redknightlois/dyi-drone/3d-parts/components/lm2596.md

# LM2596 DC-DC Buck Converter Module — Reference Specs

Adjustable step-down converter with built-in 3-digit LED voltmeter display,
two control buttons (ON/OFF and IN/OUT mode), voltage-adjustment potentiometer,
and IN/OUT indicator LEDs.

## PCB Dimensions

| Parameter | Value |
|---|---|
| PCB Length | 66 mm |
| PCB Width | 35 mm |
| PCB Thickness | 1.6 mm |
| Total Height (with components) | 14 mm |
| Weight | ~22 g |

## Mounting Holes

| Parameter | Value |
|---|---|
| Hole Pattern (L × W) | 60 × 28 mm |
| Hole Diameter | 3.0 mm (M3) |
| Hole Inset from PCB Edge (X) | 3.0 mm |
| Hole Inset from PCB Edge (Y) | 3.5 mm |

## Component Heights (above PCB)

| Component | Height | Footprint |
|---|---|---|
| LM2596 IC + Heatsink | 10 mm | 15 × 12 mm rect |
| LED 7-Segment Display | 8 mm | 30 × 14 mm rect |
| Screw Terminals (×2) | 8 mm | 10 × 7 mm rect each |
| Potentiometer (trimpot) | 5 mm | ∅6 mm |
| Control Buttons (×2) | 3 mm | ~3.5 × 3.5 mm each |
| IN/OUT Indicator LEDs (×2) | ~1 mm | SMD (~2 × 1 mm each) |
| Inductor | 6 mm | ∅10 mm |
| Electrolytic Capacitors (×2) | 8 mm | ∅8 mm each |

## Component Details

### Screw Terminals (2×)

| Parameter | Value |
|---|---|
| Terminal Block Size (L × W × H) | 10 × 7 × 8 mm |
| Wire Access Direction | ±X end walls (horizontal) |

### LM2596 IC + Heatsink

| Parameter | Value |
|---|---|
| Footprint | 15 × 12 mm |
| Height above PCB | 10 mm (tallest component) |
| Notes | Generates heat; benefits from ventilation |

### LED 7-Segment Display (3-digit voltmeter)

| Parameter | Value |
|---|---|
| Display Module Size (L × W) | 30 × 14 mm |
| Active Digit Area | ~22 × 13 mm |
| Height above PCB | 8 mm |
| Digit Color | Red |
| Voltmeter Range | 0 – 40 V |
| Voltmeter Precision | ±0.1 V (calibratable to ±0.05 V) |

### Potentiometer (Voltage Adjustment Trimpot)

| Parameter | Value |
|---|---|
| Type | Multi-turn cermet trimpot (blue) |
| Diameter | 6 mm |
| Height above PCB | 5 mm |
| Adjustment Tool | Slot-head screwdriver |
| CW Rotation | Increases output voltage |
| CCW Rotation | Decreases output voltage |

### Control Buttons (2×, tactile switches)

| Parameter | Left Button | Right Button |
|---|---|---|
| Label | ON/OFF | IN/OUT |
| Size | ~3.5 × 3.5 mm | ~3.5 × 3.5 mm |
| Height above PCB | ~3 mm | ~3 mm |

**Left Button (ON/OFF) Functions:**
- Short press: toggle voltmeter display on/off
- Long press >1 s: shut down voltmeter display
- Long press >4 s: enter self-calibration mode (range ±0.5 V)

**Right Button (IN/OUT) Functions:**
- Short press: switch display between input voltage (IN LED on) and output voltage (OUT LED on)
- Long press >2 s (calibration mode): switch between IN/OUT calibration, save value

### IN/OUT Indicator LEDs (2×)

| Parameter | Value |
|---|---|
| Type | SMD, red |
| Size | ~2 × 1 mm each |
| IN LED | Lit when displaying input voltage |
| OUT LED | Lit when displaying output voltage |

### Inductor

| Parameter | Value |
|---|---|
| Diameter | ~10 mm |
| Height above PCB | 6 mm |

### Electrolytic Capacitors (2×)

| Parameter | Input Cap | Output Cap |
|---|---|---|
| Diameter | ~8 mm | ~8 mm |
| Height above PCB | 8 mm | 8 mm |

### Internal ICs (under display / on PCB)

| Component | Package | Purpose |
|---|---|---|
| LM2596S | TO-263 (D2PAK) | Main buck regulator |
| STM8S003F3P6 | TSSOP-20 | Voltmeter MCU |
| LM317 | TO-92 | Display voltage regulator |

## Electrical Specs

| Parameter | Value |
|---|---|
| Input Voltage | 4.0 V – 40 V DC |
| Output Voltage | 1.25 V – 37 V DC (adjustable) |
| Max Output Current | 3 A (2 A sustained recommended) |
| Max Output Power | 20 W |
| Switching Frequency | 150 kHz |
| Conversion Efficiency | up to 92% |
| Protections | Input reverse polarity, output short circuit, thermal shutdown |
| Display | 3-digit red LED 7-segment voltmeter |
| Display Modes | Input voltage (IN) / Output voltage (OUT), toggled by button |

## Lid Access Requirements

When designing a lid/cover for the enclosure, these components **require** or
**benefit from** through-holes or windows:

| # | Component | Access Type | Min Opening | Required? |
|---|---|---|---|---|
| 1 | LED Display | Rectangular window | 22 × 13 mm | **Yes** — must see voltage reading |
| 2 | Potentiometer | Circular hole (screwdriver) | ∅4.0 mm | **Yes** — adjust output voltage |
| 3 | ON/OFF Button | Circular hole or slot | ∅3.6 mm | **Yes** — toggle/calibrate display |
| 4 | IN/OUT Button | Circular hole or slot | ∅3.6 mm | **Yes** — switch IN/OUT mode |
| 5 | IN LED | Small window or light pipe | ∅2.0 mm | Recommended — see active mode |
| 6 | OUT LED | Small window or light pipe | ∅2.0 mm | Recommended — see active mode |
| 7 | Heatsink area | Ventilation slots | ~15 × 12 mm zone | Recommended — thermal management |
| 8 | Screw terminals | Wall cutouts (not lid) | 12 × 10 mm per side | **Yes** — wire routing (±X walls) |

> **Note:** Items 1–4 are mandatory for normal operation. Items 5–7 improve
> usability and thermal performance. Item 8 is a wall feature, not a lid feature.

## Enclosure Derivation

The enclosure outer dimensions are derived from the mounting hole pattern:

```
BOX = HOLE_SPACING + STANDOFF_DIA + 2 × WALL
```

| Parameter | Formula | Value |
|---|---|---|
| BOX_L | 60 + 5 + 4 | 69.0 mm |
| BOX_W | 28 + 5 + 4 | 37.0 mm |
| BOX_H | (fixed) | 23.0 mm |
| Wall Thickness | — | 2.0 mm |
| Standoff Size | — | 5.0 mm square |
| Standoff Height | — | 3.0 mm |
