redknightlois/dyi-drone/(list of files, drawings)

Other design files:
src/drone-circuit.sim1
