redknightlois/dyi-drone/(commit log)

2026-02-01 First iteration - Left engines
    Implementation of the circuits and the firmware to test the circuit.
    [drone-circuit.sim1]
2026-02-01 First iteration - All engines
    WIP
    [drone-circuit.sim1]
2026-02-01 First Iteration - Unified power source
    [drone-circuit.sim1]
2026-02-01 3D parts design and export scripts
    Introduces build123d scripts for parametric drone frame design. Provides parts for the frame body, arms, prop guards, and battery cover.
    Adds export scripts to generate STL, STEP, GLTF files, and an interactive HTML viewer for visualizing and 3D printing the drone frame. Also includes a README with specifications, print settings, and assembly instructions.
2026-02-01 Refactors drone assembly with electronics
    Adds electronic components (Arduino, IMU, battery, drivers) to the 3D drone assembly for a complete visualization. Improves prop guard attachment with friction-fit sleeve. Updates battery cover rail spacing for better fit.
2026-02-08 Adds STL analyzer and component models (LM2596)
    Implements a new script for analyzing STL files, enabling the extraction of key dimensions and features for reverse engineering designs into build123d CSG primitives.
    Includes component models for Arduino R4, LiPo 2S battery, DRV8833 motor driver, and LM2596 DC-DC buck converter, enhancing assembly creation.
    Introduces enclosure design and validation scripts, improving the overall project workflow.
    Adds example enclosure designs for the LM2596, including optional lid.
    Provides enhanced visualization of parts and assemblies using ocp-vscode.
